diegobouvier/Wisflow-lora_valve_controller/README.md

# Wisflow-lora_valve_controller
Kicad proyecto for a LoRa remote valve controler actuator
