diegobouvier/Wisflow-lora_valve_controller/valve_controller_v0/production/v0.3/wis-controller_v0.3_bom-JLCPCB Assembly Order.xls

JLCPCB BOM Tool - BOM Matching
BOM name：bom-JLCPCB Assembly Order.xlsx |  |  | Download Time：2026-04-17 09:04:19 |  |  |  | * Our matching results are updated in real-time, but stock and prices may change. If it's been over 24 hours, please re-match before placing your order.
PCB Assembled Qty：5 |  |  | Est. Total Price：24.3438
Your BOM |  |  |  |  | Matched Parts |  |  |  |  |  |  | Order Information
Top Designator | Bottom Designator | Comment | Footprint | JLCPCB Part # | Matches | Part # | Manufacturer | Footprint | Description | Category | Warning | JLCPCB Part # | Product link | Lib Type | Qty | Source | Total Price ($)
C1,C4,C7 |  | 100n | 0603 |  | Select by Customer | CC0603KRX7R9BB104 | YAGEO | 0603 | 100nF 50V X7R ±10% 0603 Multilayer Ceramic Capacitors MLCC - SMD/SMT ROHS | Multilayer Ceramic Capacitors MLCC - SMD/SMT | 1.The comment (CC0603KRX7R9BB104) of this part does not match the one (100n) provided in your BOM. Please confirm; 2.Multiple lines in the BOM have been matched to the same part. Please check if the matching is correct. ; | C14663 | https://jlcpcb.com/partdetail/YAGEO-CC0603KRX7R9BB104/C14663 | Basic | 30 | 30 JLCPCB | 0.093
C16 |  | 0.1uF | 0603 |  | Select by Customer | CC0603KRX7R9BB104 | YAGEO | 0603 | 100nF 50V X7R ±10% 0603 Multilayer Ceramic Capacitors MLCC - SMD/SMT ROHS | Multilayer Ceramic Capacitors MLCC - SMD/SMT | 1.The comment (CC0603KRX7R9BB104) of this part does not match the one (0.1uF) provided in your BOM. Please confirm; 2.Multiple lines in the BOM have been matched to the same part. Please check if the matching is correct. ; | C14663 | https://jlcpcb.com/partdetail/YAGEO-CC0603KRX7R9BB104/C14663 | Basic | 30 | 30 JLCPCB | 0.093
C3,C6 |  | 10u | 0603 |  | Select by Customer | CL10A106KP8NNNC | Samsung Electro-Mechanics | 0603 | 10V 10uF X5R ±10% 0603 Multilayer Ceramic Capacitors MLCC - SMD/SMT ROHS | Multilayer Ceramic Capacitors MLCC - SMD/SMT | 1.The comment (CL10A106KP8NNNC) of this part does not match the one (10u) provided in your BOM. Please confirm; | C19702 | https://jlcpcb.com/partdetail/20411-CL10A106KP8NNNC/C19702 | Basic | 20 | 20 JLCPCB | 0.16
C10,C8,C9 |  | 10u | 0805 |  | Select by Customer | CL21A106KAYNNNE | Samsung Electro-Mechanics | 0805 | 10uF 25V X5R ±10% 0805 Multilayer Ceramic Capacitors MLCC - SMD/SMT ROHS | Multilayer Ceramic Capacitors MLCC - SMD/SMT | 1.The comment (CL21A106KAYNNNE) of this part does not match the one (10u) provided in your BOM. Please confirm; | C15850 | https://jlcpcb.com/partdetail/16532-CL21A106KAYNNNE/C15850 | Basic | 25 | 25 JLCPCB | 0.5375
C12,C14 |  | 10uF | 0603 |  | Select by Customer | 0603X106K160NT | FH (Guangdong Fenghua Advanced Tech) | 0603 | 10uF 16V X5R ±10% 0603 Multilayer Ceramic Capacitors MLCC - SMD/SMT ROHS | Multilayer Ceramic Capacitors MLCC - SMD/SMT |  | C70225 | https://jlcpcb.com/partdetail/71320-0603X106K160NT/C70225 | Extended | 20 | 20 JLCPCB | 0.548
C13 |  | 220pF | 0603 |  | Select by System | CL10B221KB8NNNC | Samsung Electro-Mechanics | 0603 | 220pF 50V X7R ±10% 0603 Multilayer Ceramic Capacitors MLCC - SMD/SMT ROHS | Multilayer Ceramic Capacitors MLCC - SMD/SMT |  | C1603 | https://jlcpcb.com/partdetail/1955-CL10B221KB8NNNC/C1603 | Basic | 20 | 20 JLCPCB | 0.112
C15 |  | 4700uF | CP_Radial_D16.0mm_P7.50mm |  | Select by System | RYHS6.3V4700UF10*16 | Honor Elec | 插件,D10xL16mm | 10mm 14mΩ@100kHz 16mm 2000hrs@105℃ 4700uF 5.35A@100kHz 6.3V Polymer Plugin,D10xL16mm Polymer Aluminum Capacitors ROHS | Polymer Aluminum Capacitors |  | C48970263 | https://jlcpcb.com/partdetail/HonorElec-RYHS6_3V4700UF1016/C48970263 | Extended | 0 | 0 JLCPCB | 0
D1 |  | BLUE | 0603 |  | Select by System | XL-1608UBC-04 | XINGLIGHT | 0603 | -40℃~+85℃ 120° 20mA 3.3V 300mcd 455nm~475nm 470nm 70mW Blue Discrete Diode Top-mount Water Clear 0603 LED Indication - Discrete ROHS | LED Indication - Discrete |  | C965807 | https://jlcpcb.com/partdetail/XINGLIGHT-XL_1608UBC04/C965807 | Extended | 20 | 20 JLCPCB | 0.084
D2,D3,D5 |  | B5819W | D_SOD-123 |  | Select by System | B5819W | hongjiacheng | SOD-123 | -55℃~+150℃ 1A 1mA@30V 40V 600mV@1A 9A Independent SOD-123 Schottky Diodes ROHS | Schottky Diodes |  | C7420330 | https://jlcpcb.com/partdetail/hongjiacheng-B5819W/C7420330 | Extended | 27 | 27 JLCPCB | 0.4509
D4 |  | D_Schottky_SS34 | Dioide_v1.4 |  | Select by System | CMS06(TE12L,Q,M) | TOSHIBA | SOD-128 | -40℃~+125℃ 1 Independent 2A 30V 370mV@2A 3mA@30V 40A SOD-128 Schottky Diodes ROHS | Schottky Diodes |  | C261920 | https://jlcpcb.com/partdetail/TOSHIBA-CMS06_TE12L_Q_M/C261920 | Extended | 5 | 0 My Parts 2 JLCPCB | 0.4376
J1 |  | 18650Socket | 18650_SMD |  | Select by Customer | BH-18650-B1BA002 | MYOUNG | SMD | -25~85℃ 18650 Battery holder Gold plating Phosphor bronze - ROHS | Button And Strip Battery Connector |  | C2988620 | https://jlcpcb.com/partdetail/MYOUNG-BH_18650B1BA002/C2988620 | Extended | 5 | 5 JLCPCB | 6.7655
J3 |  | USB_C_Receptacle_USB2.0 | USB_C_Receptacle_XKB_U262-16XN-4BVC11 |  | Select by Customer | U262-161N-4BVC11 | XKB Connection | SMD | -40℃~+85℃ 1 16P 3,000 Cycles 3A 7.3mm Female Surface Mount, Right Angle Type-C SMD USB Connectors ROHS | USB Connectors |  | C319148 | https://jlcpcb.com/partdetail/XKBConnection-U262_161N4BVC11/C319148 | Extended | 5 | 5 JLCPCB | 1.853
J6 |  | JST-2PH | JST_PH_S2B-PH-SM4-TB_1x02-1MP_P2.00mm_Horizontal |  | Select by Customer | S2B-PH-SM4-TB(LF)(SN) | JST | SMD,P=2mm,卧贴 | -25℃~+85℃ 1 100V 1x2P 2 2A 2P 2mm 5.5mm 7.9mm 8.6mm Auxiliary Solder Pin Beige Copper alloy PA PH Surface Mount, Right Angle Tin UL94V-0 SMD,P=2mm,卧贴 Wire To Board Connector ROHS | Wire To Board Connector |  | C295747 | https://jlcpcb.com/partdetail/JST-S2B_PH_SM4_TB_LF_SN/C295747 | Extended | 5 | 0 My Parts | 0
J11 |  | Solenoid_connector | TerminalBlock_bornier-4_P5.08mm |  | Select by Customer | DB128V-5.08-4P-GN-S | DORABO | 插件,P=5.08mm | -40℃~+105℃ 1 12~22 16A 1x4P 2.5 300V 4 4P 5.08mm Green M2.5 Through Hole 插件,P=5.08mm Screw Terminal Blocks ROHS | Screw Terminal Blocks |  | C2915641 | https://jlcpcb.com/partdetail/DORABO-DB128V_5_08_4P_GNS/C2915641 | Extended | 0 | 0 JLCPCB | 0
L2 |  | 6.8uH | Inductor_6R8 |  | Select by Customer | SWPA5040S6R8MT | Sunlord | SMD,5x5mm | 2.5A 2.9A 56mΩ 6.8uH ±20% SMD,5x5mm Power Inductors ROHS | Power Inductors |  | C36411 | https://jlcpcb.com/partdetail/Sunlord-SWPA5040S6R8MT/C36411 | Extended | 9 | 0 My Parts 2 JLCPCB | 0.1648
Q1 |  | DMG3415UQ-7 | SOT-23 |  | Select by Customer | DMG3415UQ-7 | Diodes Incorporated | SOT-23 | -55℃~+150℃ 1 P-Channel 104pF 20V 25pF 294pF 31mΩ@4.5V 4.9A 550mV 9.1nC@4.5V 900mW SOT-23 MOSFETs ROHS | MOSFETs |  | C459537 | https://jlcpcb.com/partdetail/DiodesIncorporated-DMG3415UQ7/C459537 | Extended | 5 | 5 JLCPCB | 0.5785
R1,R14,R2 |  | 1K | 0603 |  | Select by Customer | 0603WAF1001T5E | UNI-ROYAL(Uniroyal Elec) | 0603 | -55℃~+155℃ 100mW 1kΩ 75V Thick Film Resistor ±1% ±100ppm/℃ 0603 Chip Resistor - Surface Mount ROHS | Chip Resistor - Surface Mount | 1.The comment (0603WAF1001T5E) of this part does not match the one (1K) provided in your BOM. Please confirm; | C21190 | https://jlcpcb.com/partdetail/21904-0603WAF1001T5E/C21190 | Basic | 25 | 25 JLCPCB | 0.04
R3,R4 |  | 5.1K | 0603 |  | Select by Customer | 0603WAF5101T5E | UNI-ROYAL(Uniroyal Elec) | 0603 | -55℃~+155℃ 100mW 5.1kΩ 75V Thick Film Resistor ±1% ±100ppm/℃ 0603 Chip Resistor - Surface Mount ROHS | Chip Resistor - Surface Mount | 1.The comment (0603WAF5101T5E) of this part does not match the one (5.1K) provided in your BOM. Please confirm; | C23186 | https://jlcpcb.com/partdetail/23913-0603WAF5101T5E/C23186 | Basic | 20 | 20 JLCPCB | 0.032
R5 |  | 2.7k | 0603 |  | Select by Customer | 0603WAF2701T5E | UNI-ROYAL(Uniroyal Elec) | 0603 | -55℃~+155℃ 100mW 2.7kΩ 75V Thick Film Resistor ±1% ±100ppm/℃ 0603 Chip Resistor - Surface Mount ROHS | Chip Resistor - Surface Mount | 1.The comment (0603WAF2701T5E) of this part does not match the one (2.7k) provided in your BOM. Please confirm; | C13167 | https://jlcpcb.com/partdetail/13814-0603WAF2701T5E/C13167 | Basic | 20 | 20 JLCPCB | 0.03
R10 |  | 1.5M | 0603 |  | Select by Customer | 0603WAF1504T5E | UNI-ROYAL(Uniroyal Elec) | 0603 | -55℃~+155℃ 1.5MΩ 100mW 75V Thick Film Resistor ±1% ±100ppm/℃ 0603 Chip Resistor - Surface Mount ROHS | Chip Resistor - Surface Mount | 1.The comment (0603WAF1504T5E) of this part does not match the one (1.5M) provided in your BOM. Please confirm; | C4172 | https://jlcpcb.com/partdetail/4579-0603WAF1504T5E/C4172 | Extended | 20 | 20 JLCPCB | 0.03
R11,R9 |  | 1M | 0603 |  | Select by Customer | 0603WAF1004T5E | UNI-ROYAL(Uniroyal Elec) | 0603 | -55℃~+155℃ 100mW 1MΩ 75V Thick Film Resistor ±1% ±100ppm/℃ 0603 Chip Resistor - Surface Mount ROHS | Chip Resistor - Surface Mount | 1.The comment (0603WAF1004T5E) of this part does not match the one (1M) provided in your BOM. Please confirm; | C22935 | https://jlcpcb.com/partdetail/23662-0603WAF1004T5E/C22935 | Basic | 20 | 20 JLCPCB | 0.03
R12 |  | 174K | 0603 |  | Select by Customer | 0603WAF1743T5E | UNI-ROYAL(Uniroyal Elec) | 0603 | -55℃~+155℃ 100mW 174kΩ 75V Thick Film Resistor ±1% ±100ppm/℃ 0603 Chip Resistor - Surface Mount ROHS | Chip Resistor - Surface Mount | 1.The comment (0603WAF1743T5E) of this part does not match the one (174K) provided in your BOM. Please confirm; | C22890 | https://jlcpcb.com/partdetail/23617-0603WAF1743T5E/C22890 | Extended | 20 | 20 JLCPCB | 0.026
R13,R6,R7,R8 |  | 10K | 0603 |  | Select by Customer | 0603WAF1002T5E | UNI-ROYAL(Uniroyal Elec) | 0603 | -55℃~+155℃ 100mW 10kΩ 75V Thick Film Resistor ±1% ±100ppm/℃ 0603 Chip Resistor - Surface Mount ROHS | Chip Resistor - Surface Mount | 1.The comment (0603WAF1002T5E) of this part does not match the one (10K) provided in your BOM. Please confirm; | C25804 | https://jlcpcb.com/partdetail/26547-0603WAF1002T5E/C25804 | Basic | 30 | 30 JLCPCB | 0.042
R15 |  | 95.3K | 0603 |  | Select by Customer | 0603WAF9532T5E | UNI-ROYAL(Uniroyal Elec) | 0603 | -55℃~+155℃ 100mW 75V 95.3kΩ Thick Film Resistor ±1% ±100ppm/℃ 0603 Chip Resistor - Surface Mount ROHS | Chip Resistor - Surface Mount | 1.The comment (0603WAF9532T5E) of this part does not match the one (95.3K) provided in your BOM. Please confirm; | C23267 | https://jlcpcb.com/partdetail/23994-0603WAF9532T5E/C23267 | Extended | 20 | 20 JLCPCB | 0.026
R16 |  | 243K | 0603 |  | Select by Customer | 0603WAF2433T5E | UNI-ROYAL(Uniroyal Elec) | 0603 | -55℃~+155℃ 100mW 243kΩ 75V Thick Film Resistor ±1% ±100ppm/℃ 0603 Chip Resistor - Surface Mount ROHS | Chip Resistor - Surface Mount | 1.The comment (0603WAF2433T5E) of this part does not match the one (243K) provided in your BOM. Please confirm; | C23351 | https://jlcpcb.com/partdetail/24084-0603WAF2433T5E/C23351 | Extended | 20 | 20 JLCPCB | 0.026
R17 |  | 34 | 2512 |  | Select by Customer | 25121WF340JT4E | UNI-ROYAL(Uniroyal Elec) | 2512 | -55℃~+155℃ 1W 200V 34Ω Thick Film Resistor ±1% ±100ppm/℃ 2512 Chip Resistor - Surface Mount ROHS | Chip Resistor - Surface Mount | 1.The comment (25121WF340JT4E) of this part does not match the one (34) provided in your BOM. Please confirm; | C421576 | https://jlcpcb.com/partdetail/414526-25121WF340JT4E/C421576 | Extended | 13 | 13 JLCPCB | 0.3757
R18,R19 |  | 1.5K | 0603 |  | Select by Customer | 0603WAF1501T5E | UNI-ROYAL(Uniroyal Elec) | 0603 | -55℃~+155℃ 1.5kΩ 100mW 75V Thick Film Resistor ±1% ±100ppm/℃ 0603 Chip Resistor - Surface Mount ROHS | Chip Resistor - Surface Mount | 1.The comment (0603WAF1501T5E) of this part does not match the one (1.5K) provided in your BOM. Please confirm; | C22843 | https://jlcpcb.com/partdetail/23570-0603WAF1501T5E/C22843 | Basic | 20 | 20 JLCPCB | 0.034
SW1 |  | RESET | SW_SPST_B3U-1000P |  | Select by Customer | B3U-1000P | Omron Electronics | SMD,3x2.5mm | -25℃~+70℃ 1.53N 1.6mm 12V 2.5mm 3mm 50mA Round Button SMD(SMT) Tab SPST Surface Mount,Vertical SMD,3x2.5mm Tactile Switches ROHS | Tactile Switches | 1.The comment (B3U-1000P) of this part does not match the one (RESET) provided in your BOM. Please confirm; | C231329 | https://jlcpcb.com/partdetail/OmronElectronics-B3U1000P/C231329 | Extended | 7 | 0 My Parts 1 JLCPCB | 0.1948
SW3 |  | SW_DIP_x02 | WIS_DIP_Switch |  | Select by Customer | SMXMS-02K-TP | SM Switch | SMD,P=1.27mm | -30℃~+85℃ 1.27mm 2 24V 25mA 3,000 Cycles Black SMD,P=1.27mm DIP Switches ROHS | DIP Switches |  | C5439234 | https://jlcpcb.com/partdetail/SMSwitch-SMXMS_02KTP/C5439234 | Extended | 5 | 0 My Parts | 0
SW4 |  | BOOT | Slide_switch |  | Select by Customer | K3-1290S-E1 | Korean Hroparts Elec | SMD,6.6x2.7mm | -25℃~+80℃ 1.4mm 10000 times 2.7mm 300mA 4V 6.6mm Black Rectangular Columnar SMD(SMT) Tab SPDT Surface Mount, Right Angle SMD,6.6x2.7mm Slide Switches ROHS | Slide Switches |  | C145854 | https://jlcpcb.com/partdetail/Korean_HropartsElec-K3_1290SE1/C145854 | Extended | 9 | 0 My Parts 6 JLCPCB | 0.456
U1 |  | RAK3172 | RAK3172 |  | Select by Customer | RAK3172-9-SM-I | RAKwireless | SMD,15.5x15mm | -40℃~+85℃ 15km 2V~3.6V 5.22mA 87mA IPEX interface SPI、UART、I2C SMD,15.5x15mm LoRa Modules ROHS | LoRa Modules | 1.The comment (RAK3172-9-SM-I) of this part does not match the one (RAK3172) provided in your BOM. Please confirm; | C19723905 | https://jlcpcb.com/partdetail/RAKwireless-RAK3172_9_SMI/C19723905 | Extended | 5 | 0 My Parts | 0
U2 |  | CH340E | MSOP-10_3x3mm_P0.5mm |  | Select by System | CH340E | WCH(Jiangsu Qin Heng) | MSOP-10 | 150uA 20mA 2Mbps 3.3V、5V Transceiver USB 2.0 MSOP-10 USB Converters ROHS | USB Converters |  | C99652 | https://jlcpcb.com/partdetail/WCH_Jiangsu_Qin_Heng-CH340E/C99652 | Extended | 5 | 5 JLCPCB | 3.475
U3 |  | BQ21040DBV | SOT-23-6 |  | Select by System | BQ21040DBVR | Texas Instruments | SOT-23-6 | 0℃~+125℃ 1 125uA 3.5V~28V 4.2V 800mA Charging IC Support SOT-23-6 Battery Management ROHS | Battery Management |  | C202311 | https://jlcpcb.com/partdetail/TexasInstruments-BQ21040DBVR/C202311 | Extended | 5 | 5 JLCPCB | 1.491
U4 |  | XC6220B331MR-G | SOT-23-5 |  | Select by System | XC6220B331MR-G | Torex Semicon | SOT-25 | -40℃~+85℃ 1 1A 3.3V 50dB@(1kHz) 655mV@(1A) 6V 8uA Fixed Over Current Protection、Over Temperature Protection、Enable、Short Circuit Protection Positive SOT-25 Voltage Regulators - Linear, Low Drop Out (LDO) Regulators ROHS | Voltage Regulators - Linear, Low Drop Out (LDO) Regulators |  | C86534 | https://jlcpcb.com/partdetail/TorexSemicon-XC6220B331MRG/C86534 | Extended | 5 | 5 JLCPCB | 2.378
U5 |  | LMR62421XMF | SOT-23-5 |  | Select by System | LMR62421XMFX/NOPB | Texas Instruments | SOT-23-5 | -40℃~+125℃@(TJ) 1 1.6MHz 2.1A 2.7V~24V 2.7V~5.5V Adjustable Boost Boost、SEPIC Built-in Yes SOT-23-5 DC-DC Converters ROHS | DC-DC Converters |  | C544413 | https://jlcpcb.com/partdetail/TexasInstruments-LMR62421XMFXNOPB/C544413 | Extended | 5 | 5 JLCPCB | 3.7795
U6 |  | LT218 | SOP-4 |  | Select by System | LT218 | Letex | SOP-4-2.54mm | -40℃~+85℃ 1.2V 1.5kV 2.5A 20us 40V 500mW 50mA 60mΩ 800us One set normally open: 2A (SPST - normally open) SOP-4-2.54mm Solid State Relays (MOS Output) ROHS | Solid State Relays (MOS Output) |  | C2691607 | https://jlcpcb.com/partdetail/Letex-LT218/C2691607 | Extended | 5 | 0 My Parts | 0
U7,U8 |  | DRV8231ADSGR | DRV8231ADSGR |  | Select by System | DRV8231ADSGR | Texas Instruments | WSON-8(2x2) | -40℃~+150℃ 1 1uA 3.7A 4.5V~33V 600mΩ Yes WSON-8(2x2) Brushed DC Motor Drivers ROHS | Brushed DC Motor Drivers |  | C5139865 | https://jlcpcb.com/partdetail/TexasInstruments-DRV8231ADSGR/C5139865 | Extended | 10 | 0 My Parts | 0
U11 |  | XKB5858-Z-F-75 | WIS-Push_Button |  | Select by System | XKB5858-Z-F-75 | XKB Connection | SMD | -15℃~+55℃ 100,000 cycles 100mA 2.5N 30V Gull Wing Latching Square Button Surface Mount, Right Angle White Without SMD Pushbutton Switches ROHS | Pushbutton Switches |  | C2884736 | https://jlcpcb.com/partdetail/XKBConnection-XKB5858_Z_F75/C2884736 | Extended | 5 | 0 My Parts | 0
