diegobouvier/Wisflow-lora_valve_controller/valve_controller_v0/wis-controller-v0.3.kicad_pcb

## KiCad design valve_controller_v0/wis-controller-v0.3.kicad_pcb (2026-06-03)

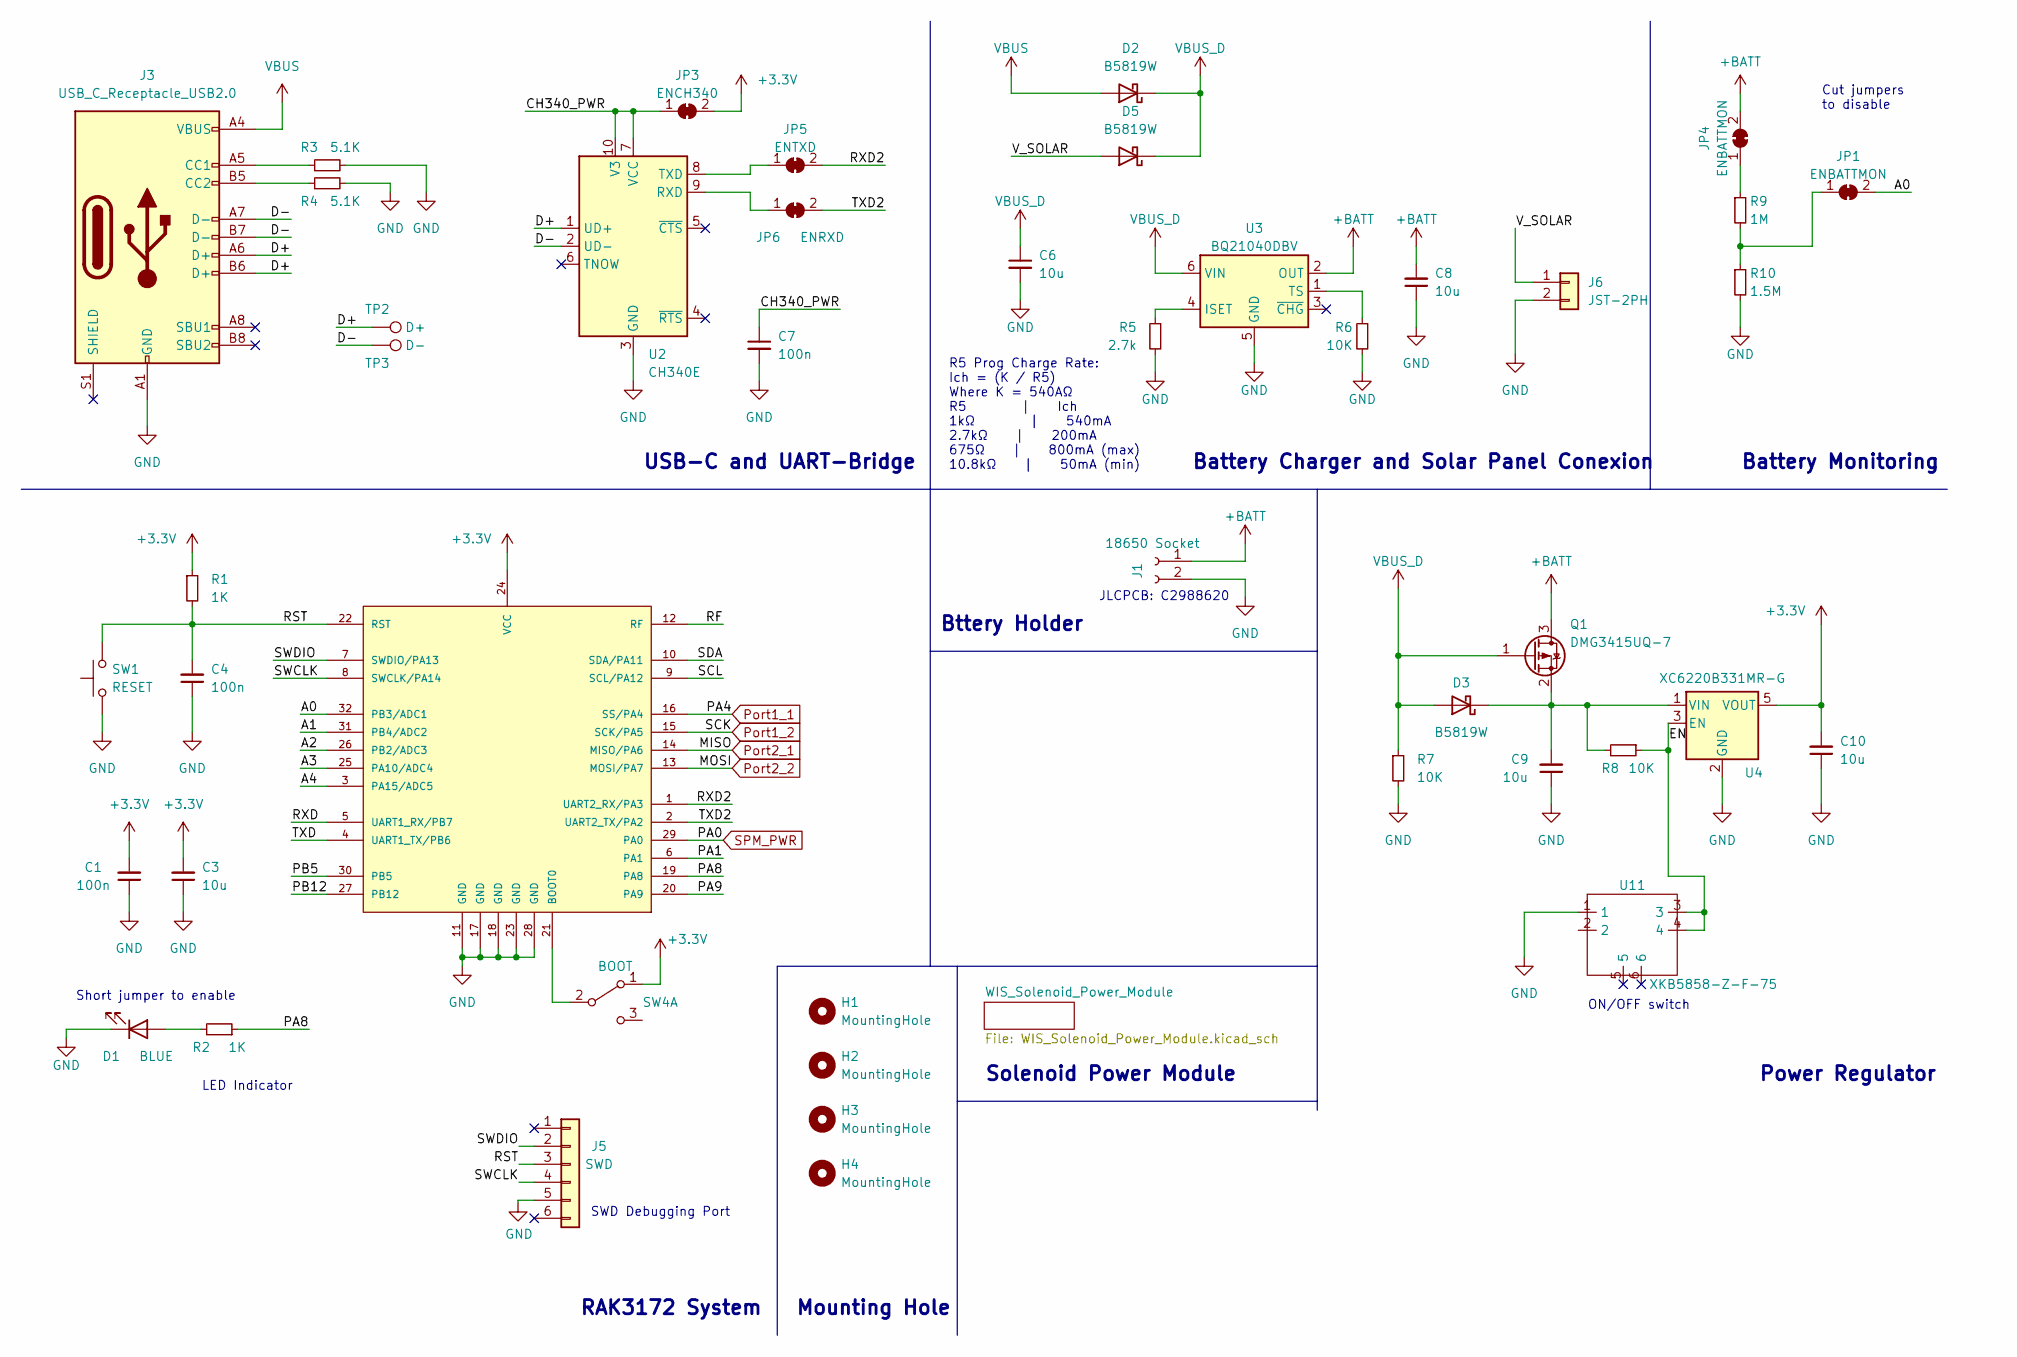
[picture p1: schematic wis-controller-v0.3.kicad_sch, WIS Controller RAK3172]

Parts:
C1, C4, C7: 100n; C_0603_1608Metric; Part Description Ceramic Capacitor 100nF 10% 10V X7R
C3, C6: 10u; C_0603_1608Metric; Part Description Ceramic Capacitor 10uF 10% 10V X5R
C8, C9, C10: 10u; C_0805_2012Metric; Part Description Ceramic Capacitor 10uF 10% 10V X5R
D1: BLUE; LED_0603_1608Metric; Part Description Blue 2V 25mA
D2, D5: B5819W; D_SOD-123
D3: B5819W; D_SOD-123; Part Description 0.05mA@40V 0.58V@1A
H1, H2, H3, H4: MountingHole; MountingHole_2.5mm
J1: 18650 Socket; BatteryHolder_MPD_BK-18650-PC2
J3: USB_C_Receptacle_USB2.0; USB_C_Receptacle_XKB_U262-16XN-4BVC11; Part Number U262-161N-4BVC11
J5: SWD; Tag-Connect_TC2030-IDC-NL_2x03_P1.27mm_Vertical
J6: JST-2PH; JST_PH_S2B-PH-SM4-TB_1x02-1MP_P2.00mm_Horizontal; Part Number JST-PH S2B-PH-SM4-TB
JP1, JP4: ENBATTMON; SolderJumper-2_P1.3mm_Bridged_RoundedPad1.0x1.5mm
JP3: ENCH340; SolderJumper-2_P1.3mm_Bridged_RoundedPad1.0x1.5mm
JP5: ENTXD; SolderJumper-2_P1.3mm_Bridged_RoundedPad1.0x1.5mm
JP6: ENRXD; SolderJumper-2_P1.3mm_Bridged_RoundedPad1.0x1.5mm
Q1: DMG3415UQ-7; SOT-23; Part Number DMG3415UQ-7
R1, R2: 1K; R_0603_1608Metric; Part Description Resistor 1k 5% 100mW
R3, R4: 5.1K; R_0603_1608Metric; Part Description Resistor 5.1K 1% 100mW
R5: 2.7k; R_0603_1608Metric; Part Description Resistor 5.1k 1% 100mW
R6, R7, R8: 10K; R_0603_1608Metric; Part Description Resistor 10k 5% 100mW
R9: 1M; R_0603_1608Metric; Part Description Resistor 4.7M 1% 100mW
R10: 1.5M; R_0603_1608Metric; Part Description Resistor 10M 1% 100mW
SW1: RESET; SW_SPST_B3U-1000P; Part Number B3U-1000P
SW4: BOOT; Slide_switch
TP2: D+; TestPoint_Pad_D1.0mm
TP3: D-; TestPoint_Pad_D1.0mm
U1: RAK3172; Part Number RAK3172
U2: CH340E; MSOP-10_3x3mm_P0.5mm; Part Number CH340E
U3: BQ21040DBV; SOT-23-6
U4: XC6220B331MR-G; SOT-23-5; Part Number XC6220B331MR-G
U11: XKB5858-Z-F-75; WIS-Push_Button

Connections:
+3.3V: C1.2, C3.2, C10.2, JP3.2 (B), R1.1, SW4.1 (A), U1.24 (VCC), U4.5 (VOUT); also elsewhere on the board
+BATT: C8.2, J1.1, JP4.2 (B), Q1.3 (D), U3.2 (OUT); also elsewhere on the board
/A0: JP1.2 (B), U1.32 (PB3/ADC1)
/A1: U1.31 (PB4/ADC2)
/A2: U1.26 (PB2/ADC3)
/A3: U1.25 (PA10/ADC4)
/A4: U1.3 (PA15/ADC5)
/CH340_PWR: C7.1, JP3.1 (A), U2.7 (VCC), U2.10 (V3)
/D+: J3.A6 (D+), J3.B6 (D+), TP2.1, U2.1 (UD+)
/D-: J3.A7 (D-), J3.B7 (D-), TP3.1, U2.2 (UD-)
/EN: R8.1, U4.3 (EN), U11.3, U11.4
/PA1: U1.6 (PA1)
/PA8: R2.1, U1.19 (PA8)
/PA9: U1.20 (PA9)
/PB5: U1.30 (PB5)
/PB12: U1.27 (PB12)
/RF: U1.12 (RF)
/RST: C4.2, J5.3, R1.2, SW1.2, U1.22 (RST)
/RXD: U1.5 (UART1_RX/PB7)
/RXD2: JP5.2 (B), U1.1 (UART2_RX/PA3)
/SCL: U1.9 (SCL/PA12)
/SDA: U1.10 (SDA/PA11)
/SWCLK: J5.4, U1.8 (SWCLK/PA14)
/SWDIO: J5.2, U1.7 (SWDIO/PA13)
/TXD: U1.4 (UART1_TX/PB6)
/TXD2: JP6.2 (B), U1.2 (UART2_TX/PA2)
/V_SOLAR: D5.2 (A), J6.1
GND: C1.1, C3.1, C4.1, C6.2, C7.2, C8.1, C9.1, C10.1, D1.1 (K), J1.2, J3.A1 (GND), J3.A12 (GND), J3.B1 (GND), J3.B12 (GND), J5.5, J6.2, R3.2, R4.2, R5.2, R6.2, R7.2, R10.2, SW1.1, U1.11 (GND), U1.17 (GND), U1.18 (GND), U1.23 (GND), U1.28 (GND), U2.3 (GND), U3.5 (GND), U4.2 (GND), U11.1; also elsewhere on the board
unnamed: D1.2 (A), R2.2
unnamed: C9.2, D3.1 (K), Q1.2 (S), R8.2, U4.1 (VIN)
unnamed: J3.A5 (CC1), R3.1
unnamed: J3.B5 (CC2), R4.1
unnamed: JP1.1 (A), R9.2, R10.1
unnamed: JP4.1 (A), R9.1
unnamed: JP5.1 (A), U2.8 (TXD)
unnamed: JP6.1 (A), U2.9 (RXD)
unnamed: SW4.2 (B), U1.21 (BOOT0)
unnamed: R5.1, U3.4 (ISET)
unnamed: R6.1, U3.1 (TS)
Port1_1: U1.16 (SS/PA4); also elsewhere on the board
Port1_2: U1.15 (SCK/PA5); also elsewhere on the board
Port2_1: U1.14 (MISO/PA6); also elsewhere on the board
Port2_2: U1.13 (MOSI/PA7); also elsewhere on the board
SPM_PWR: U1.29 (PA0); also elsewhere on the board
VBUS: D2.2 (A), J3.A4 (VBUS), J3.A9 (VBUS), J3.B4 (VBUS), J3.B9 (VBUS)
VBUS_D: C6.1, D2.1 (K), D3.2 (A), D5.1 (K), Q1.1 (G), R7.1, U3.6 (VIN)

Notes on the sheet:
ON/OFF switch
Battery Monitoring
RAK3172 System
Mounting Hole
R5 Prog Charge Rate: Ich = (K / R5) Where K = 540AΩ R5 | Ich 1kΩ | 540mA 2.7kΩ | 200mA 675Ω | 800mA (max) 10.8kΩ | 50mA (min)
Cut jumpers to disable
JLCPCB: C2988620
Short jumper to enable
USB-C and UART-Bridge
SWD Debugging Port
LED Indicator
Solenoid Power Module
Power Regulator
Battery Charger and Solar Panel Conexion
Bttery Holder

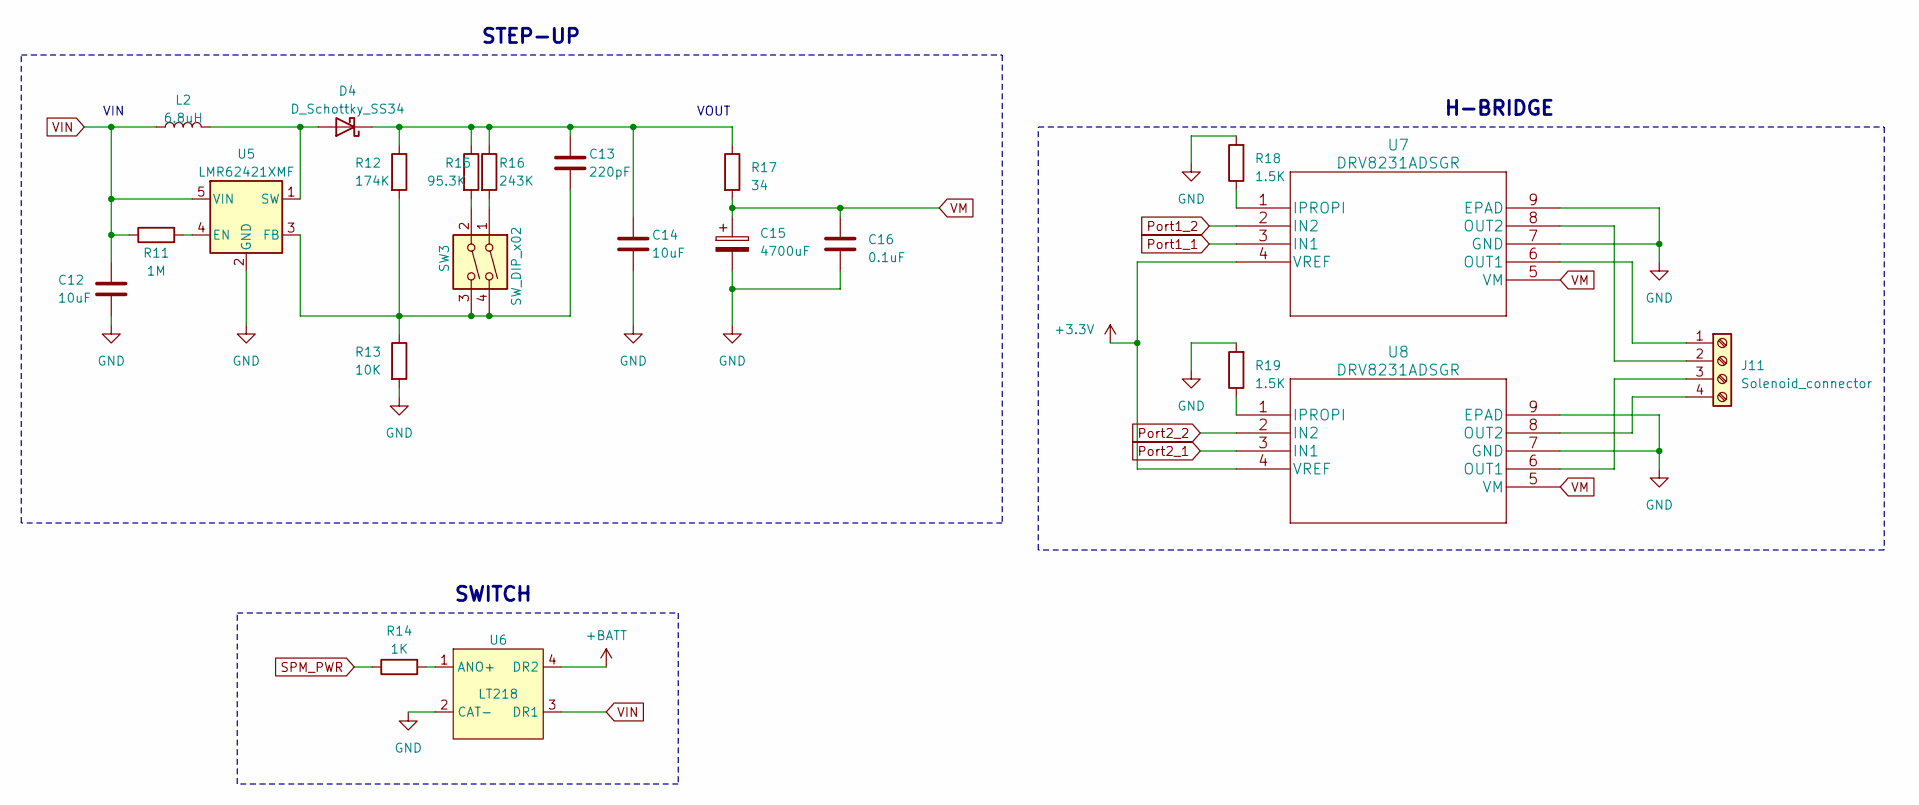
[picture p2: schematic WIS_Solenoid_Power_Module.kicad_sch]

Parts:
C12, C14: 10uF; C_0603_1608Metric
C13: 220pF; C_0603_1608Metric
C15: 4700uF; CP_Radial_D16.0mm_P7.50mm
C16: 0.1uF; C_0603_1608Metric
D4: D_Schottky_SS34; Dioide_v1.4
J11: Solenoid_connector; TerminalBlock_bornier-4_P5.08mm
L2: 6.8uH; Inductor_6R8
R11: 1M; R_0603_1608Metric
R12: 174K; R_0603_1608Metric
R13: 10K; R_0603_1608Metric
R14: 1K; R_0603_1608Metric
R15: 95.3K; R_0603_1608Metric
R16: 243K; R_0603_1608Metric
R17: 34; R_2512_6332Metric
R18, R19: 1.5K; R_0603_1608Metric
SW3: SW_DIP_x02; WIS_DIP_Switch
U5: LMR62421XMF; SOT-23-5
U6: LT218; SOP-4
U7, U8: DRV8231ADSGR

Connections:
+3.3V: U7.4 (VREF), U8.4 (VREF); also elsewhere on the board
+BATT: U6.4 (DR2); also elsewhere on the board
GND: C12.2, C14.2, C15.2, C16.2, R13.2, R18.2, R19.2, U5.2 (GND), U6.2 (CAT-), U7.7 (GND), U7.9 (EPAD), U8.7 (GND), U8.9 (EPAD); also elsewhere on the board
unnamed: D4.2 (A), L2.2, U5.1 (SW)
unnamed: C13.1, C14.1, D4.1 (K), R12.1, R15.1, R16.1, R17.1
unnamed: J11.1, U7.6 (OUT1)
unnamed: J11.2, U7.8 (OUT2)
unnamed: J11.3, U8.6 (OUT1)
unnamed: J11.4, U8.8 (OUT2)
unnamed: R15.2, SW3.2
unnamed: R16.2, SW3.1
unnamed: R11.2, U5.4 (EN)
unnamed: C13.2, R12.2, R13.1, SW3.3, SW3.4, U5.3 (FB)
unnamed: R14.2, U6.1 (ANO+)
unnamed: R18.1, U7.1 (IPROPI)
unnamed: R19.1, U8.1 (IPROPI)
Port1_1: U7.3 (IN1); also elsewhere on the board
Port1_2: U7.2 (IN2); also elsewhere on the board
Port2_1: U8.3 (IN1); also elsewhere on the board
Port2_2: U8.2 (IN2); also elsewhere on the board
SPM_PWR: R14.1; also elsewhere on the board
VIN: C12.1, L2.1, R11.1, U5.5 (VIN), U6.3 (DR1)
VM: C15.1, C16.1, R17.2, U7.5 (VM), U8.5 (VM)

Notes on the sheet:
H-BRIDGE
STEP-UP
SWITCH
VOUT
VIN

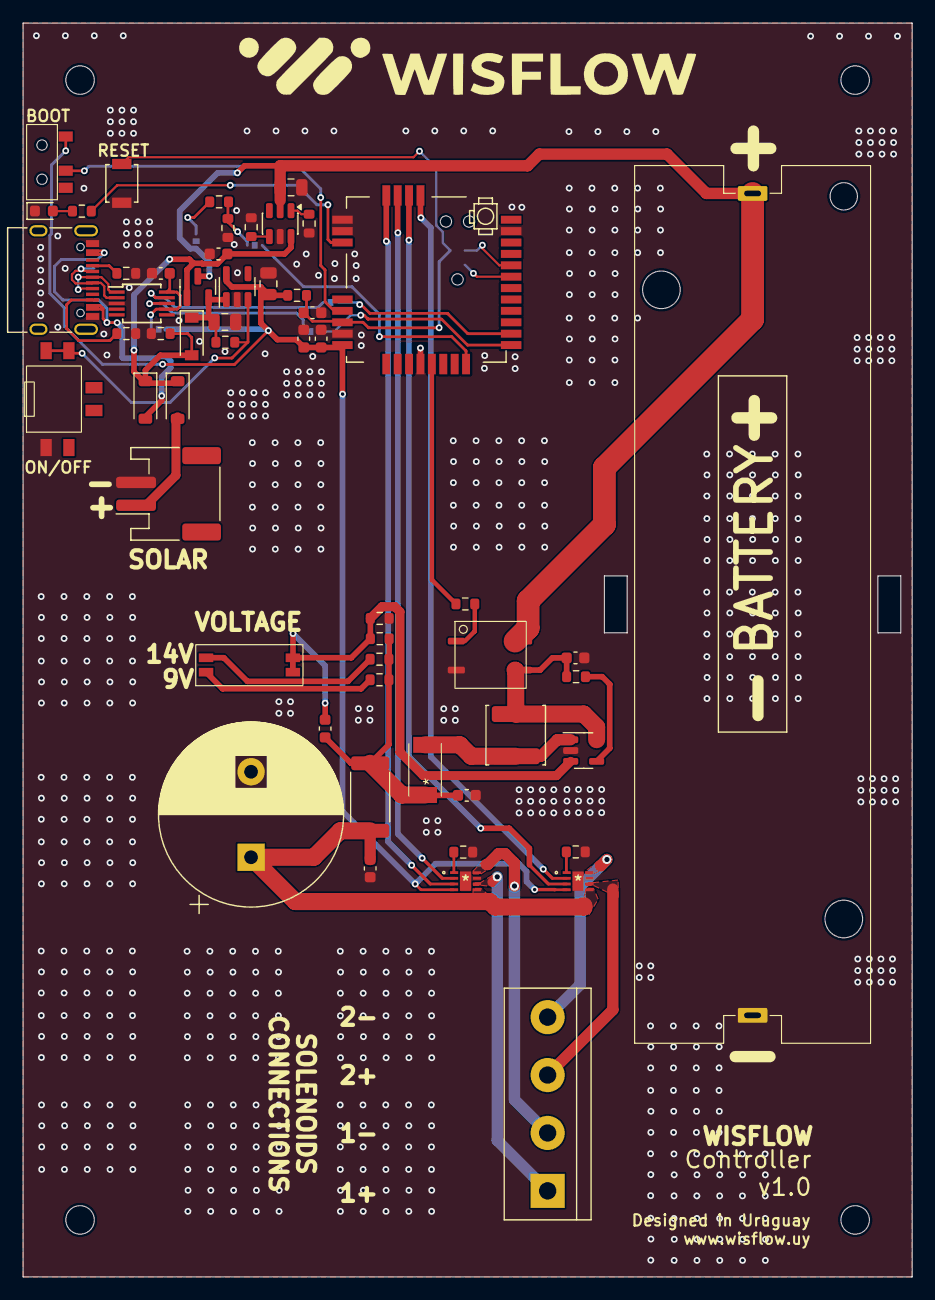
[picture p3: board wis-controller-v0.3.kicad_pcb from above]

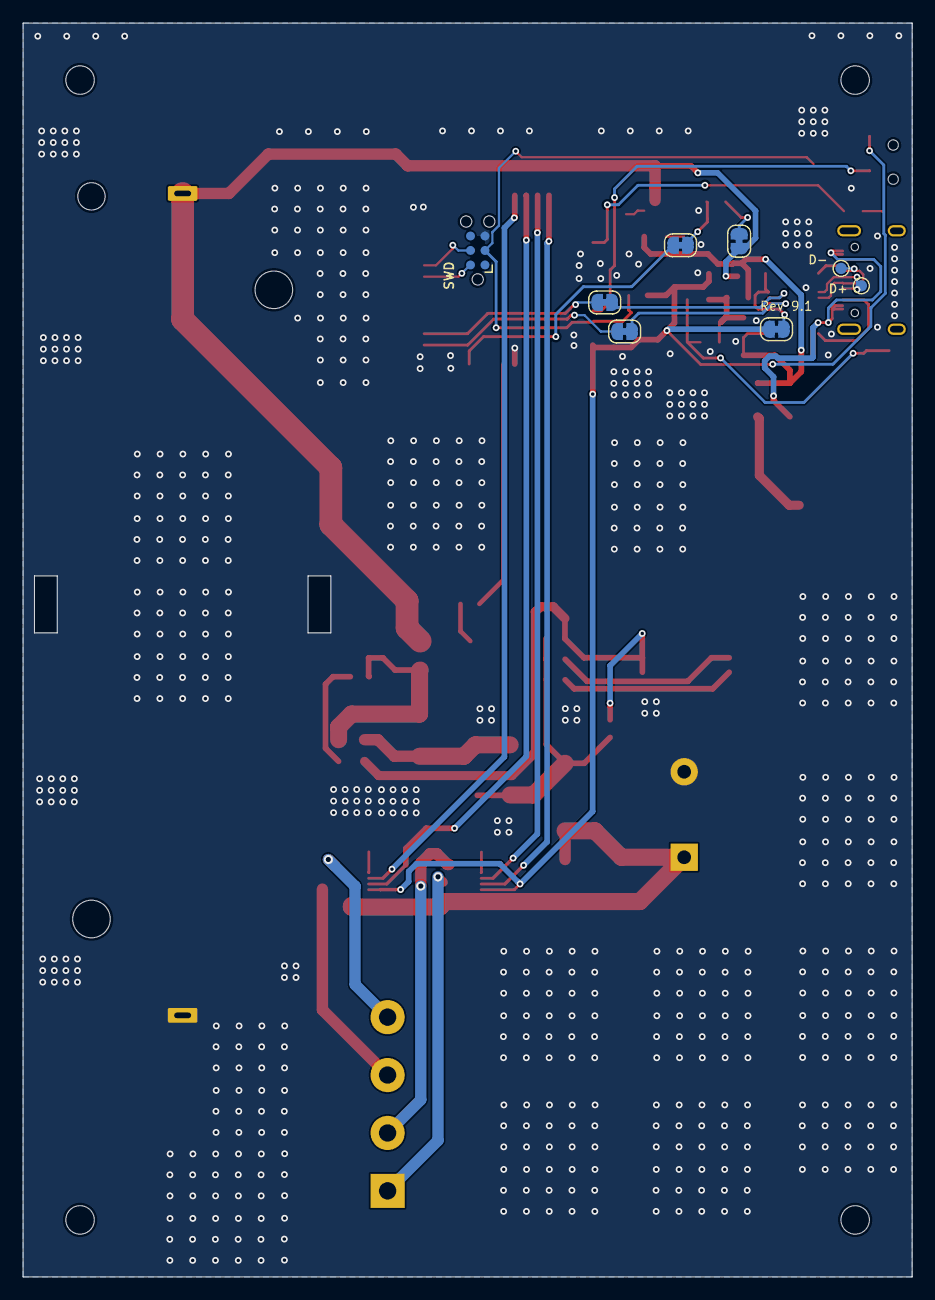
[picture p4: board wis-controller-v0.3.kicad_pcb from below]

Board: 2 copper layers, 78.0 x 110.0 mm, 67 parts (8 on the bottom side), 48 nets.
