diegobouvier/Wisflow-lora_valve_controller/(commit log)

2026-03-24 Add v0 of the PCB
    Added the original version of hte PCB to the repository
    [WIS_Solenoid_Power_Module.kicad_sch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]
2026-03-26 Replaced battery charger and battery holder
    - Replaced battery charger to support the new solar panel
    - Replaced the battery holder by a plastic enclosure one
    - Reconnected the on/off switch to avoid putting EN pin floating temporarly whne swithced
    [WIS_Solenoid_Power_Module.kicad_sch, wis-controller-v0.3.kicad_pcb, wis-controller-v0.3.kicad_sch]
2026-03-26 Uniformized D2,D3 and D5
    - Selected the same partnumber forD2, D3 and D5, all of the 1A and 40V.
    [WIS_Solenoid_Power_Module.kicad_sch, wis-controller-v0.3.kicad_pcb, wis-controller-v0.3.kicad_sch]
2026-03-26 Removed most of user comments measurements
    [wis-controller-v0.3.kicad_pcb]
2026-04-06 Solenoid terminal block relocated
    [wis-controller-v0.3.kicad_pcb]
2026-04-14 Updated v0.3 for fabrication
    - Removed unnecesary via in U11 pad2
    - Solved courtyard overlaping of J3-D1, J3-R2, U1-C4 and U1-C1
    - Removed silkscreen for R6 and U3
    - Generated manufacturing files (production folder)
    [wis-controller-v0.3.kicad_pcb, wis-controller_v0.3_bom.csv, wis-controller_v0.3_designators.csv, wis-controller_v0.3_positions.csv]
2026-04-16 Updated BOM according to manufacturing
    Downloaded the final BOM after components selection in JLCPCB
    [bom.xls]
2026-04-18 Updated the 18650 battery holder
    Changed the battery holder for the 18650 battery. Created new footprint and updated the PCB layout. Added cutouts for zip-ties
    [wis-controller-v0.3.kicad_pcb, wis-controller-v0.3.kicad_sch]
2026-04-18 Updated the PCB order design
    Updated the PCB order files. Created v0.3b and updated v0.3 files
    [bom.csv, bom.xls, designators.csv, positions.csv, wis-controller_v0.3_bom-JLCPCB Assembly Order.xls, wis-controller_v0.3_bom.csv, wis-controller_v0.3_designators.csv, wis-controller_v0.3_positions.csv]
2026-04-19 Corected the location of the solenoid connector
    Reverted the modification of the solenoid connector to maintain its original position
    [positions.csv, wis-controller-v0.3.kicad_pcb]
2026-05-26 Modified location of silkscreen
    Modified the location of the silkscreen to avoid being covered by the output connector
    [bom.csv, bom_modified.csv, designators.csv, positions.csv, wis-controller-v0.3.kicad_pcb]
2026-06-03 Corrected inductor L2 footprint
    The footprint of L2 was incorrect and JLCPCB rejected to solder it (The same design was already manufactured before)
    [bom.csv, bom_modified_v2.csv, wis-controller-v0.3.kicad_pcb]
